cjgriscom/EEGR4253/README.md

# EEGR4253
Microcomputer Design - Spring 2017
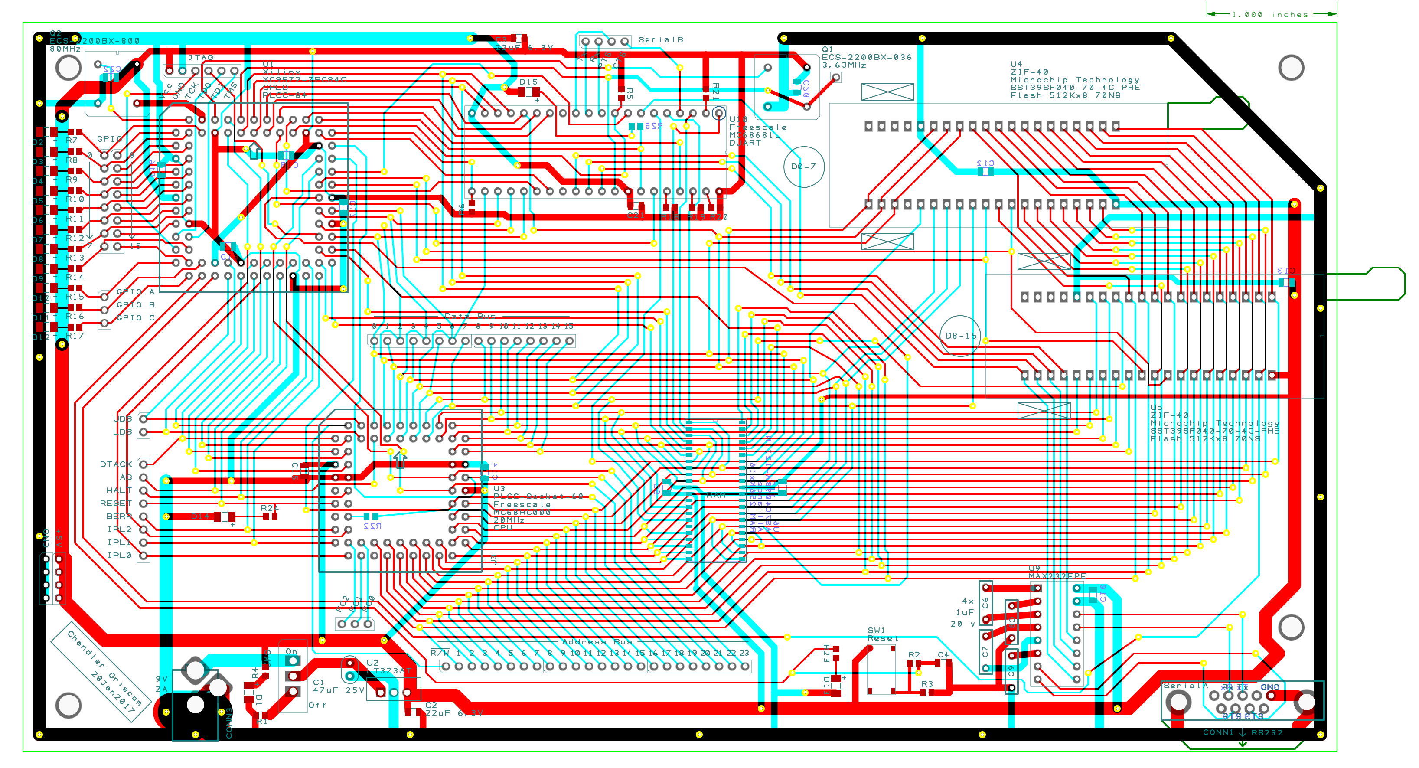
[picture p1: Export/PCB_EXPORT_AllLayers.png]
