cjgriscom/EEGR4253/PCB v2/Computer_v2 (PCB - Back Annotation Renames Report).txt

Back Annotation Renames Report
------------------------------

Report File:        Y:\Homeschool\Semester6\Microcomputer\PCB v2\Computer_v2 (PCB - Back Annotation Renames Report).txt
Report Written:     Tuesday, May 16, 2017
Project Path:       Y:\Homeschool\Semester6\Microcomputer\PCB v2\Computer.prj
Design Path:        Y:\Homeschool\Semester6\Microcomputer\PCB v2\Computer_v2.pcb
Design Title:       
Created:            5/7/2017 6:59:04 PM
Last Saved:         5/16/2017 4:39:36 PM
Editing Time:       10499 min
Units:              inches (precision 3)

Outstanding PCB renames awaiting back annotation to the Schematics design.

Change Value on Component 'D15' - 'Meaning'.
Rename Net from "N0261" to "NRGPLED".
Rename Net from "N0260" to "GPLED".

End Of Report.
