cjgriscom/EEGR4253/Reports/MONITOR PROG.odt

Ignore E pin

lds, uds, dtack, r/w, ce pins

Separate RAM/ROM w/r

Check validity of addresses

Read / write registers

Menu: pg 909

1. Read Register

2. Write Register

3. Read RAM

4. Write RAM

5. Read ROM

6. Write ROM

7. Load S Reg

8. Run S Reg

UI Description, menu flow

CHECK SYLLABUS
