cjgriscom/EEGR4253/Reports/Progress Report 1.odt

Microcomputer Design

Chandler Griscom

18Jan2016

Design Report #1

I. Time
  a. Christmas Break – 3 Hours
  b. Week 1 – 6 Hours
  c. Week 2 – 1 Hour
II. Accomplishments
  a. Ordered CPLD, processor, ZIF and PLCC sockets from eBay
  b. Selected all major components and put them into Digikey/Mouser carts
  c. Made major design decisions and preliminary schematic (emailed)
III. Planned Work
  a. Order all parts by Friday
  b. Begin drawing component footprints in PCBArtist
IV. Project Completion
  a. Hardware: 10%
  b. Software: 0%
