cjgriscom/EEGR4253/Reports/Progress Report 3.odt

Microcomputer Design

Chandler Griscom

01Jan2016

Design Report #3

I. Time – 29.5 Hours total
  a. Week 3 (Wed-Sun) – 20 Hours
  b. Week 4 (Mon-Wed) – 9.5 Hours
II. Accomplishments
  a. Completed schematic and emailed it to Dr. Kim
  b. Verified components, made some symbol corrections
  c. Finished PCB
  d. Ordered PCB!
III. Planned Work
  a. Take a break
  b. Start looking into CPLD programming
IV. Project Completion
  a. Hardware: 90%
  b. Software: 2%


(PCB Progress 30Jan2017)
