cjgriscom/EEGR4253/Reports/Progress Report 7.odt

Microcomputer Design

Chandler Griscom

01Mar2016

Design Report #7

I. Time – 3 Hours total
II. Accomplishments
  a. Helped Colin with DUART and Brian with soldering
  b. Planned out some details related to flash S record storage
  c. I did not finish much else due to tests and projects in CS classes
III. Planned Work
  a. Finish monitor program
  b. Change S record code to permanently upload programs to flash
IV. Project Completion
  a. Hardware: 100%
  b. Software: 80%
