cjgriscom/EEGR4253/Reports/BlockDiagram.pdf

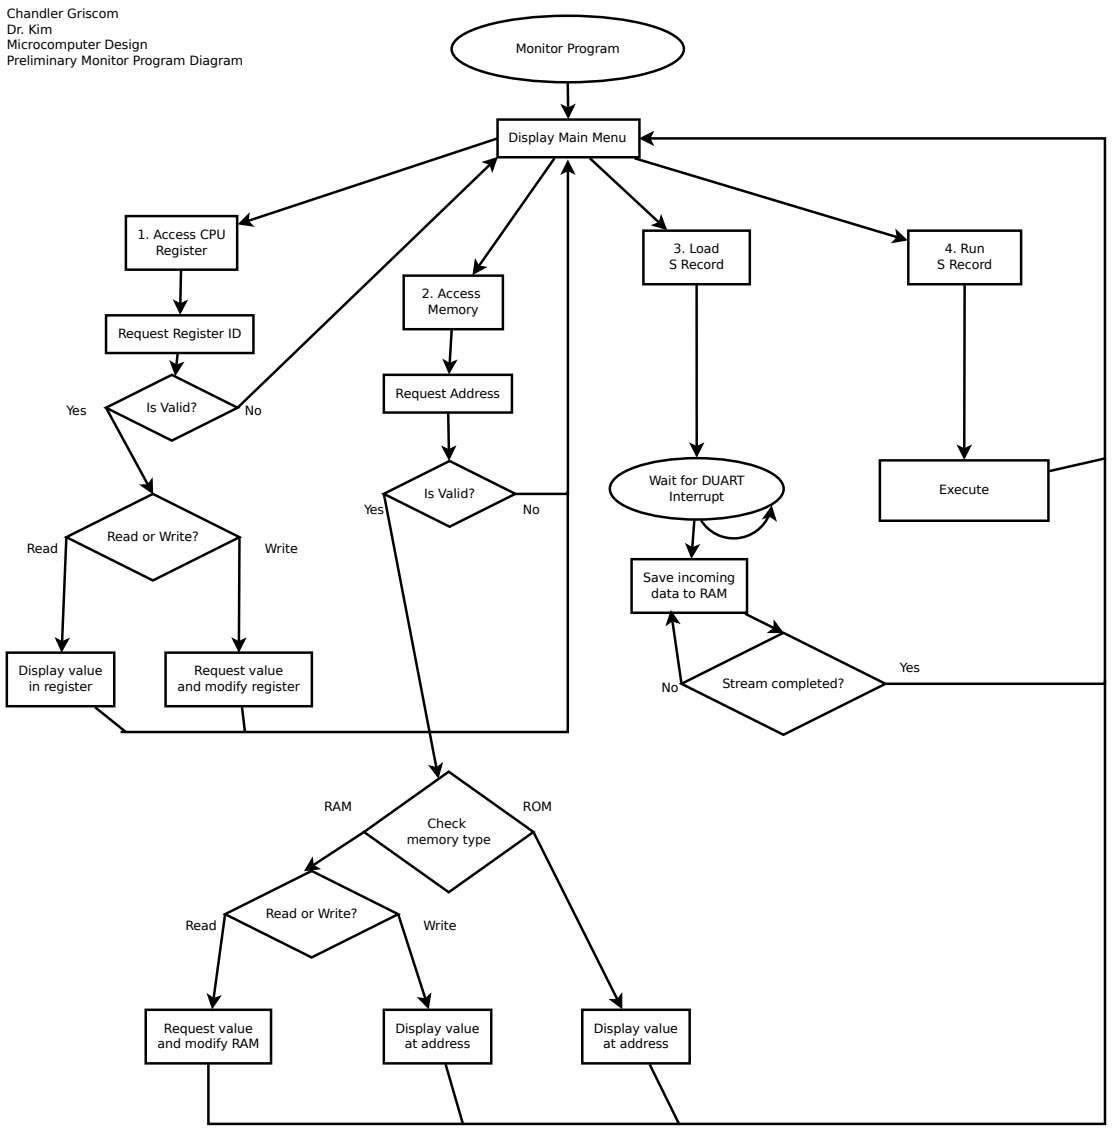
[picture p17: figure]
Display Main Menu; 1. Access CPU Register; 2. Access Memory; 3. Load S Record; 4. Run S Record; Is Valid?; Monitor Program; Chandler Griscom Dr. Kim Microcomputer Design Preliminary Monitor Program Diagram; Wait for DUART Interrupt; Save incoming data to RAM; Stream completed?; Yes; Execute; Request Address; Check memory type; Request Register ID; Read or Write?; Request value and modify register; Request value and modify RAM; Display value at address; Display value in register; Read; Write; RAM; ROM
