cjgriscom/EEGR4253/Monitor Design.ods

ROM Organization
0 | 2000 | 4000 | 6000 | 8000 | … | 40000 | …
Monitor | Reserved | ROMBurner | ProgData | Prog0 |  | Data block 0
ProgData (bytes)
0 | 1 | 2 | 3 | 4 | 5 | 6 | 7 | 8 | 9 | A
Version | Start Addr
