cjgriscom/EEGR4253/Datasheets/68-PCC1.gif

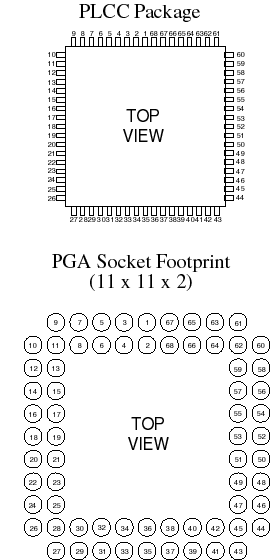
Datasheets/68-PCC1.gif
