cjgriscom/EEGR4253/Datasheets/DEBOUNCE.png

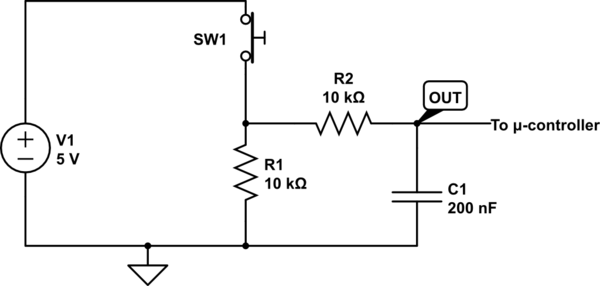
Datasheets/DEBOUNCE.png
