cjgriscom/EEGR4253/Export/0209171253-00.jpg

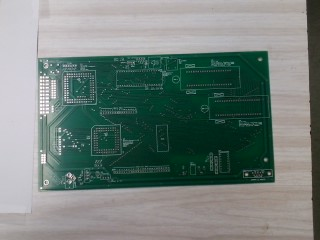
Export/0209171253-00.jpg
