cjgriscom/EEGR4253/Export/0209171253-01.jpg

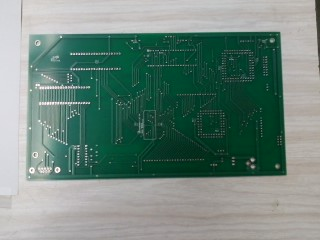
Export/0209171253-01.jpg
