cjgriscom/EEGR4253/Export/boardwhite.png

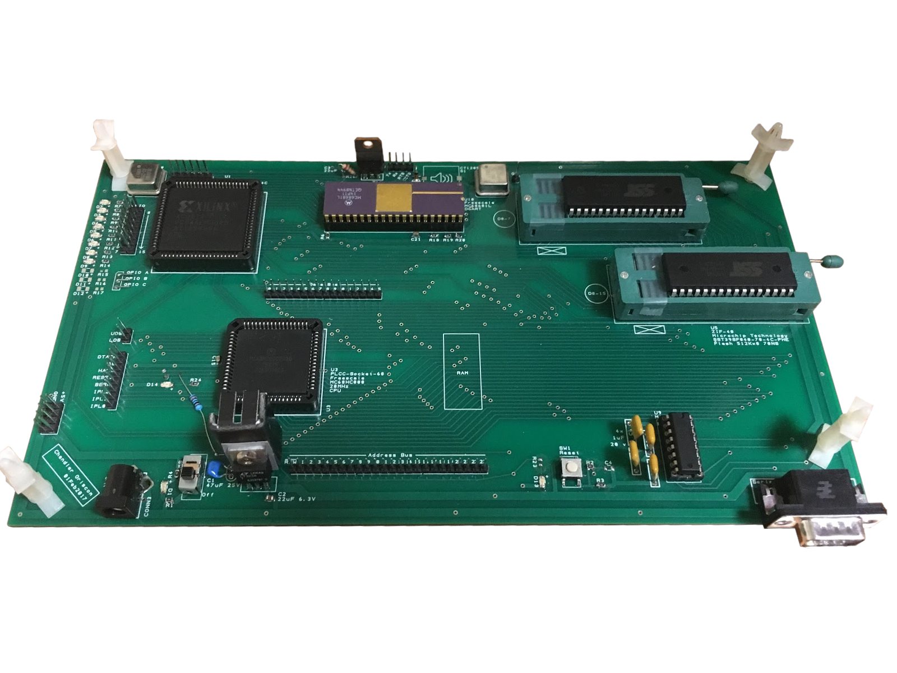
Export/boardwhite.png
