cjgriscom/EEGR4253/Reports/Prelim.png

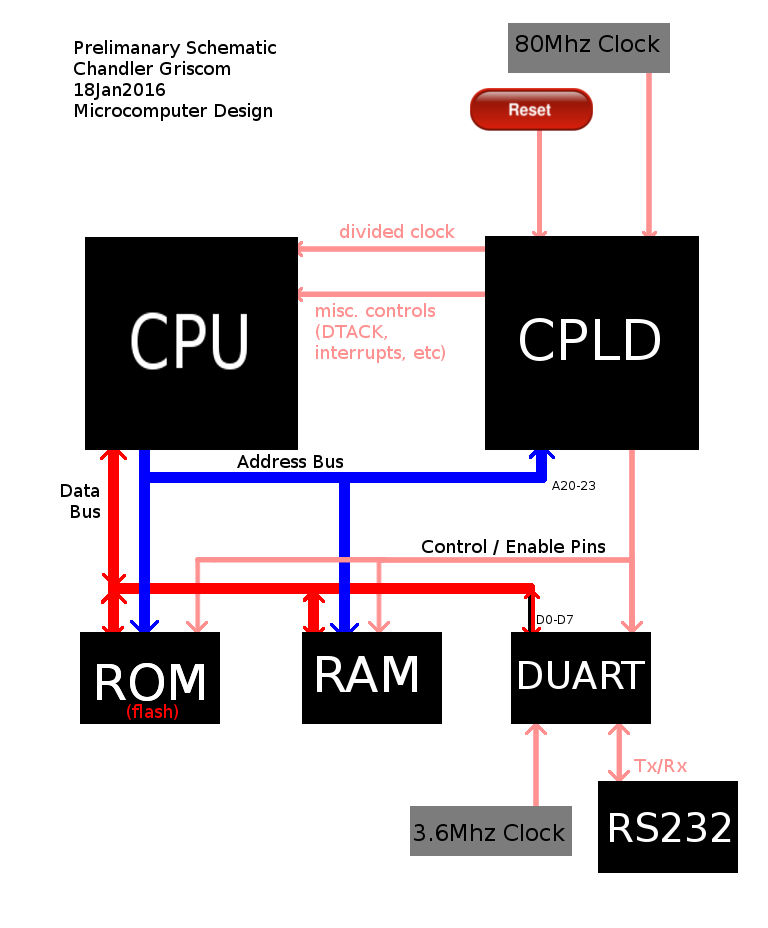
Reports/Prelim.png
