cjgriscom/EEGR4253/MicroprocLibs/Components.txt

Component libraries (*.cml)

=============================

Library : Apem_Switches    {C:\users\Public\Documents\PCB Artist\Library}

===========================================================================

Component   Ref Scm Symbol  Scm Library                                                  Package         Pcb Symbol      Pcb Library
--------------------------------------------------------------------------------------------------------------------------------------------------------------------------------------------------
2554        U   SW2         Apem_Switches {C:\users\Public\Documents\PCB Artist\Library} SWITCH_25546NA  SWITCH_25546NA  Apem_Switches {C:\users\Public\Documents\PCB Artist\Library}
5232CDB     U   SW1_IXI     Apem_Switches {C:\users\Public\Documents\PCB Artist\Library} SWITCH_5232CDB  SWITCH_5232CDB  Apem_Switches {C:\users\Public\Documents\PCB Artist\Library}
5236CDB     U   SW1_IXI     Apem_Switches {C:\users\Public\Documents\PCB Artist\Library} SWITCH_5232CDB  SWITCH_5232CDB  Apem_Switches {C:\users\Public\Documents\PCB Artist\Library}
5237CDB     U   SW1_IXI     Apem_Switches {C:\users\Public\Documents\PCB Artist\Library} SWITCH_5232CDB  SWITCH_5232CDB  Apem_Switches {C:\users\Public\Documents\PCB Artist\Library}
9233CD      U   SW_2P       Switches {C:\users\Public\Documents\PCB Artist\Library}      SWITCH_9233CD   SWITCH_9233CD   Apem_Switches {C:\users\Public\Documents\PCB Artist\Library}
21136NA     U   SW1_IXI     Apem_Switches {C:\users\Public\Documents\PCB Artist\Library} SWITCH_21136    SWITCH_21136    Apem_Switches {C:\users\Public\Documents\PCB Artist\Library}
25136NAH    U   SW1_IXI     Apem_Switches {C:\users\Public\Documents\PCB Artist\Library} SWITCH_25136NAH SWITCH_25136NAH Apem_Switches {C:\users\Public\Documents\PCB Artist\Library}
25146NAH    U   SW2_IXI     Apem_Switches {C:\users\Public\Documents\PCB Artist\Library} SWITCH_25146NAH SWITCH_25146NAH Apem_Switches {C:\users\Public\Documents\PCB Artist\Library}
25336NA     U   SW1_IXI     Apem_Switches {C:\users\Public\Documents\PCB Artist\Library} SWITCH_25336NA  SWITCH_25336NA  Apem_Switches {C:\users\Public\Documents\PCB Artist\Library}
25546NA     U   SW2         Apem_Switches {C:\users\Public\Documents\PCB Artist\Library} SWITCH_25546NA  SWITCH_25546NA  Apem_Switches {C:\users\Public\Documents\PCB Artist\Library}
DS02        U   SW4_A       Apem_Switches {C:\users\Public\Documents\PCB Artist\Library} SWITCH_DS02V    SWITCH_DS02V    Apem_Switches {C:\users\Public\Documents\PCB Artist\Library}
DS02V       U   SW4_A       Apem_Switches {C:\users\Public\Documents\PCB Artist\Library} SWITCH_DS02V    SWITCH_DS02V    Apem_Switches {C:\users\Public\Documents\PCB Artist\Library}
DS04        U   SW6_A       Apem_Switches {C:\users\Public\Documents\PCB Artist\Library} SWITCH_DS04V    SWITCH_DS04V    Apem_Switches {C:\users\Public\Documents\PCB Artist\Library}
DS04V       U   SW6_A       Apem_Switches {C:\users\Public\Documents\PCB Artist\Library} SWITCH_DS04V    SWITCH_DS04V    Apem_Switches {C:\users\Public\Documents\PCB Artist\Library}
DS06        U   SW6_A       Apem_Switches {C:\users\Public\Documents\PCB Artist\Library} SWITCH_DS06V    SWITCH_DS06V    Apem_Switches {C:\users\Public\Documents\PCB Artist\Library}
DS06V       U   SW6_A       Apem_Switches {C:\users\Public\Documents\PCB Artist\Library} SWITCH_DS06V    SWITCH_DS06V    Apem_Switches {C:\users\Public\Documents\PCB Artist\Library}
DS08        U   SW8_A       Apem_Switches {C:\users\Public\Documents\PCB Artist\Library} SWITCH_DS08V    SWITCH_DS08V    Apem_Switches {C:\users\Public\Documents\PCB Artist\Library}
DS08V       U   SW8_A       Apem_Switches {C:\users\Public\Documents\PCB Artist\Library} SWITCH_DS08V    SWITCH_DS08V    Apem_Switches {C:\users\Public\Documents\PCB Artist\Library}
DS10        U   SW10_A      Apem_Switches {C:\users\Public\Documents\PCB Artist\Library} SWITCH_DS10V    SWITCH_DS10V    Apem_Switches {C:\users\Public\Documents\PCB Artist\Library}
DS10V       U   SW10_A      Apem_Switches {C:\users\Public\Documents\PCB Artist\Library} SWITCH_DS10V    SWITCH_DS10V    Apem_Switches {C:\users\Public\Documents\PCB Artist\Library}
NDI04S      U   SW4_A       Apem_Switches {C:\users\Public\Documents\PCB Artist\Library} SWITCH_NDI04SVX SWITCH_NDI04SVX Apem_Switches {C:\users\Public\Documents\PCB Artist\Library}
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
MLL4760   D   DIODE-1    Diode {C:\users\Public\Documents\PCB Artist\Library} MLL41   MLL41
MLL4761   D   DIODE-1    Diode {C:\users\Public\Documents\PCB Artist\Library} MLL41   MLL41
MLL4762   D   DIODE-1    Diode {C:\users\Public\Documents\PCB Artist\Library} MLL41   MLL41
MLL4763   D   DIODE-1    Diode {C:\users\Public\Documents\PCB Artist\Library} MLL41   MLL41
MLL4764   D   DIODE-1    Diode {C:\users\Public\Documents\PCB Artist\Library} MLL41   MLL41
MZ605     D   DIODE-1    Diode {C:\users\Public\Documents\PCB Artist\Library} DIOD04  DIOD04     discrete {C:\users\Public\Documents\PCB Artist\Library}
MZ610     D   DIODE-1    Diode {C:\users\Public\Documents\PCB Artist\Library} DIOD04  DIOD04     discrete {C:\users\Public\Documents\PCB Artist\Library}
MZ620     D   DIODE-1    Diode {C:\users\Public\Documents\PCB Artist\Library} DIOD04  DIOD04     discrete {C:\users\Public\Documents\PCB Artist\Library}
MZ640     D   DIODE-1    Diode {C:\users\Public\Documents\PCB Artist\Library} DIOD04  DIOD04     discrete {C:\users\Public\Documents\PCB Artist\Library}
MZ2361    D   DIODE-2    Diode {C:\users\Public\Documents\PCB Artist\Library} DIOD05  DIOD05

Library : discrete    {C:\users\Public\Documents\PCB Artist\Library}

======================================================================

Component Ref  Scm Symbol Scm Library                                             Package Pcb Symbol  Pcb Library
--------------------------------------------------------------------------------------------------------------------------------------------------------------------------
7SEG      DISP 7SEG2      discrete {C:\users\Public\Documents\PCB Artist\Library} DIP     LED10DIL300 discrete {C:\users\Public\Documents\PCB Artist\Library}
Battery   BAT  Battery    discrete {C:\users\Public\Documents\PCB Artist\Library} MISC    Battery     discrete {C:\users\Public\Documents\PCB Artist\Library}
C         C    C          discrete {C:\users\Public\Documents\PCB Artist\Library} SM      C0805
                                                                                  DSC     DISC03      discrete {C:\users\Public\Documents\PCB Artist\Library}
CP        C    CP         discrete {C:\users\Public\Documents\PCB Artist\Library} SM      C3527
                                                                                  DSCV    CAPP3V      discrete {C:\users\Public\Documents\PCB Artist\Library}
CP-SM     C    CP         discrete {C:\users\Public\Documents\PCB Artist\Library} SM      C3527
                                                                                  DSCV    CAPP3V      discrete {C:\users\Public\Documents\PCB Artist\Library}
CP1       C    CP         discrete {C:\users\Public\Documents\PCB Artist\Library} DSCV    CAPP1V      discrete {C:\users\Public\Documents\PCB Artist\Library}
CP3       C    CP         discrete {C:\users\Public\Documents\PCB Artist\Library} DSCV    CAPP3V      discrete {C:\users\Public\Documents\PCB Artist\Library}
CP4       C    CP         discrete {C:\users\Public\Documents\PCB Artist\Library} DSCV    CAPP4V      discrete {C:\users\Public\Documents\PCB Artist\Library}
CP5       C    CP         discrete {C:\users\Public\Documents\PCB Artist\Library} DSCV    CAPP5V      discrete {C:\users\Public\Documents\PCB Artist\Library}
CP6       C    CP         discrete {C:\users\Public\Documents\PCB Artist\Library} DSCV    CAPP6V      discrete {C:\users\Public\Documents\PCB Artist\Library}
CT1       C    CT         discrete {C:\users\Public\Documents\PCB Artist\Library} DSC     CT3         discrete {C:\users\Public\Documents\PCB Artist\Library}
                                                                                  DSCV    CT5         discrete {C:\users\Public\Documents\PCB Artist\Library}
                                                                                  MISC    CT1         discrete {C:\users\Public\Documents\PCB Artist\Library}
CT2       C    CT         discrete {C:\users\Public\Documents\PCB Artist\Library} DSC     CT4         discrete {C:\users\Public\Documents\PCB Artist\Library}
                                                                                  DSCV    CT6         discrete {C:\users\Public\Documents\PCB Artist\Library}
                                                                                  MISC    CT2         discrete {C:\users\Public\Documents\PCB Artist\Library}
CV1       C    CV         discrete {C:\users\Public\Documents\PCB Artist\Library} DSC     CV1         discrete {C:\users\Public\Documents\PCB Artist\Library}
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
R_PRE     R    RP         discrete {C:\users\Public\Documents\PCB Artist\Library} DSC     POT1H       discrete {C:\users\Public\Documents\PCB Artist\Library}
                                                                                  DSCV    POT1V       discrete {C:\users\Public\Documents\PCB Artist\Library}
R_PREC    R    RP         discrete {C:\users\Public\Documents\PCB Artist\Library} DSC     POT2H       discrete {C:\users\Public\Documents\PCB Artist\Library}
                                                                                  DSCV    POT2V       discrete {C:\users\Public\Documents\PCB Artist\Library}
R_PREM    R    RP         discrete {C:\users\Public\Documents\PCB Artist\Library} DSC     POT3H       discrete {C:\users\Public\Documents\PCB Artist\Library}
                                                                                  DSCV    POT3V       discrete {C:\users\Public\Documents\PCB Artist\Library}
SCR       D    SCR        discrete {C:\users\Public\Documents\PCB Artist\Library} SM      SOT23
SPDT      SW   SPDT       switch {C:\users\Public\Documents\PCB Artist\Library}   DSC     SPDTHH      discrete {C:\users\Public\Documents\PCB Artist\Library}
                                                                                  DSCV    SPDTV       discrete {C:\users\Public\Documents\PCB Artist\Library}
                                                                                  MISC    SPDTHV      discrete {C:\users\Public\Documents\PCB Artist\Library}
SW_FSM2JH SW   PUSH-NO    switch {C:\users\Public\Documents\PCB Artist\Library}   DISC    FSM2JH      discrete {C:\users\Public\Documents\PCB Artist\Library}
TRIAC     D    TRIAC      discrete {C:\users\Public\Documents\PCB Artist\Library} SM      SOT23
                                                                                  DSC     TO92        discrete {C:\users\Public\Documents\PCB Artist\Library}
XTAL      XTAL XTAL       discrete {C:\users\Public\Documents\PCB Artist\Library} DSC     HC18U       discrete {C:\users\Public\Documents\PCB Artist\Library}
ZENER     ZD   ZENERD     discrete {C:\users\Public\Documents\PCB Artist\Library} DSC     DIOD03      discrete {C:\users\Public\Documents\PCB Artist\Library}
                                                                                  MISC    DIOD04      discrete {C:\users\Public\Documents\PCB Artist\Library}

Library : Finder_Relays    {C:\users\Public\Documents\PCB Artist\Library}

===========================================================================

Component        Ref Scm Symbol     Scm Library                                           Package          Pcb Symbol       Pcb Library
----------------------------------------------------------------------------------------------------------------------------------------------------
30.22.7.005.0010 U   RELAY_SW2_C1   Relays {C:\users\Public\Documents\PCB Artist\Library} RELAY_30XXX      RELAY_30XXX
30.22.7.012.0010 U   RELAY_SW2_C1   Relays {C:\users\Public\Documents\PCB Artist\Library} RELAY_30XXX      RELAY_30XXX
30.22.7.024.0010 U   RELAY_SW2_C1   Relays {C:\users\Public\Documents\PCB Artist\Library} RELAY_30XXX      RELAY_30XXX
32.21.7.005.2000 U   RELAY_SW1_C1   Relays {C:\users\Public\Documents\PCB Artist\Library} RELAY_32XXX      RELAY_32XXX
32.21.7.012.2000 U   RELAY_SW1_C1   Relays {C:\users\Public\Documents\PCB Artist\Library} RELAY_32XXX      RELAY_32XXX
32.21.7.024.2000 U   RELAY_SW1_C1   Relays {C:\users\Public\Documents\PCB Artist\Library} RELAY_32XXX      RELAY_32XXX
34.51.7.005.0010 U   RELAY_SW1_C1   Relays {C:\users\Public\Documents\PCB Artist\Library} RELAY_34.51      RELAY_34.51
34.51.7.024.0019 U   RELAY_SW1_C1   Relays {C:\users\Public\Documents\PCB Artist\Library} RELAY_34.51      RELAY_34.51
34.81.7.005.8240 U   RELAY_SW1_C1_A Relays {C:\users\Public\Documents\PCB Artist\Library} RELAY_34.81      RELAY_34.81
34.81.7.005.9024 U   RELAY_SW1_C1_A Relays {C:\users\Public\Documents\PCB Artist\Library} RELAY_34.81      RELAY_34.81
34.81.7.012.9024 U   RELAY_SW1_C1_A Relays {C:\users\Public\Documents\PCB Artist\Library} RELAY_34.81      RELAY_34.81
34.81.7.024.8240 U   RELAY_SW1_C1_A Relays {C:\users\Public\Documents\PCB Artist\Library} RELAY_34.81      RELAY_34.81
34.81.7.024.9024 U   RELAY_SW1_C1_A Relays {C:\users\Public\Documents\PCB Artist\Library} RELAY_34.81      RELAY_34.81
36.11.9.005.0000 U   RELAY_SW1_C1   Relays {C:\users\Public\Documents\PCB Artist\Library} RELAY_36.11.0000 RELAY_36.11.0000
36.11.9.012.0000 U   RELAY_SW1_C1   Relays {C:\users\Public\Documents\PCB Artist\Library} RELAY_36.11.0000 RELAY_36.11.0000
36.11.9.024.0000 U   RELAY_SW1_C1   Relays {C:\users\Public\Documents\PCB Artist\Library} RELAY_36.11.0000 RELAY_36.11.0000
36.11.9.024.0300 U   RELAY_SW1_C1_A Relays {C:\users\Public\Documents\PCB Artist\Library} RELAY_36.11.0300 RELAY_36.11.0300
40.31.7.012.0000 U   RELAY_SW1_C1   Relays {C:\users\Public\Documents\PCB Artist\Library} RELAY_40.31      RELAY_40.31
40.31.7.024.0000 U   RELAY_SW1_C1   Relays {C:\users\Public\Documents\PCB Artist\Library} RELAY_40.31      RELAY_40.31
40.31.8.012.0000 U   RELAY_SW1_C1   Relays {C:\users\Public\Documents\PCB Artist\Library} RELAY_40.31      RELAY_40.31
40.31.8.024.0000 U   RELAY_SW1_C1   Relays {C:\users\Public\Documents\PCB Artist\Library} RELAY_40.31      RELAY_40.31
40.31.8.110.0000 U   RELAY_SW1_C1   Relays {C:\users\Public\Documents\PCB Artist\Library} RELAY_40.31      RELAY_40.31
40.31.8.230.0000 U   RELAY_SW1_C1   Relays {C:\users\Public\Documents\PCB Artist\Library} RELAY_40.31      RELAY_40.31
40.31.7006.0000  U   RELAY_SW1_C1   Relays {C:\users\Public\Documents\PCB Artist\Library} RELAY_40.31      RELAY_40.31
40.51.9.012.0000 U   RELAY_SW1_C1   Relays {C:\users\Public\Documents\PCB Artist\Library} RELAY_40.51      RELAY_40.51
40.51.9024.000   U   RELAY_SW1_C1   Relays {C:\users\Public\Documents\PCB Artist\Library} RELAY_40.51      RELAY_40.51
40.52.7.006.0000 U   RELAY_SW2_C1   Relays {C:\users\Public\Documents\PCB Artist\Library} RELAY_40.52      RELAY_40.52
40.52.7.012.0000 U   RELAY_SW2_C1   Relays {C:\users\Public\Documents\PCB Artist\Library} RELAY_40.52      RELAY_40.52
40.52.7.024.0000 U   RELAY_SW2_C1   Relays {C:\users\Public\Documents\PCB Artist\Library} RELAY_40.52      RELAY_40.52
40.52.7.048.0000 U   RELAY_SW2_C1   Relays {C:\users\Public\Documents\PCB Artist\Library} RELAY_40.52      RELAY_40.52
40.52.8.012.0000 U   RELAY_SW2_C1   Relays {C:\users\Public\Documents\PCB Artist\Library} RELAY_40.52      RELAY_40.52
40.52.8.024.0000 U   RELAY_SW2_C1   Relays {C:\users\Public\Documents\PCB Artist\Library} RELAY_40.52      RELAY_40.52
40.52.8.110.0000 U   RELAY_SW2_C1   Relays {C:\users\Public\Documents\PCB Artist\Library} RELAY_40.52      RELAY_40.52
40.52.8.230.0000 U   RELAY_SW2_C1   Relays {C:\users\Public\Documents\PCB Artist\Library} RELAY_40.52      RELAY_40.52
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
62.32.8230.0010  U   RELAY_SW2_C1   Relays {C:\users\Public\Documents\PCB Artist\Library} RELAY_62.32      RELAY_62.32
3451.7012.0010   U   RELAY_SW1_C1   Relays {C:\users\Public\Documents\PCB Artist\Library} RELAY_34.51      RELAY_34.51
3451.7024.0010   U   RELAY_SW1_C1   Relays {C:\users\Public\Documents\PCB Artist\Library} RELAY_34.51      RELAY_34.51
3451.7060.0010   U   RELAY_SW1_C1   Relays {C:\users\Public\Documents\PCB Artist\Library} RELAY_34.51      RELAY_34.51
4452 9012        U   RELAY_SW2_C1   Relays {C:\users\Public\Documents\PCB Artist\Library} RELAY_44.52      RELAY_44.52
4452 9024        U   RELAY_SW2_C1   Relays {C:\users\Public\Documents\PCB Artist\Library} RELAY_44.52      RELAY_44.52
4452 9048        U   RELAY_SW2_C1   Relays {C:\users\Public\Documents\PCB Artist\Library} RELAY_44.52      RELAY_44.52
4661.8012.0040   U   RELAY_SW1_C1   Relays {C:\users\Public\Documents\PCB Artist\Library} RELAY_46.61      RELAY_46.61
5532.8024.0040   U   RELAY_55.32    Relays {C:\users\Public\Documents\PCB Artist\Library} RELAY_55.32      RELAY_55.32
5532.8230.0040   U   RELAY_55.32    Relays {C:\users\Public\Documents\PCB Artist\Library} RELAY_55.32      RELAY_55.32
5532.9012.0040   U   RELAY_55.32    Relays {C:\users\Public\Documents\PCB Artist\Library} RELAY_55.32      RELAY_55.32
5532.9024.0040   U   RELAY_55.32    Relays {C:\users\Public\Documents\PCB Artist\Library} RELAY_55.32      RELAY_55.32
5532.9048.0040   U   RELAY_55.32    Relays {C:\users\Public\Documents\PCB Artist\Library} RELAY_55.32      RELAY_55.32
5534.9048.0040   U   RELAY_SW4_C1_A Relays {C:\users\Public\Documents\PCB Artist\Library} RELAY_55.34      RELAY_55.34
501290051000     U   RELAY_SW2_C1   Relays {C:\users\Public\Documents\PCB Artist\Library} RELAY_50XXX      RELAY_50XXX
501290121000     U   RELAY_SW2_C1   Relays {C:\users\Public\Documents\PCB Artist\Library} RELAY_50XXX      RELAY_50XXX
501290241000     U   RELAY_SW2_C1   Relays {C:\users\Public\Documents\PCB Artist\Library} RELAY_50XXX      RELAY_50XXX
501290481000     U   RELAY_SW2_C1   Relays {C:\users\Public\Documents\PCB Artist\Library} RELAY_50XXX      RELAY_50XXX
501291101000     U   RELAY_SW2_C1   Relays {C:\users\Public\Documents\PCB Artist\Library} RELAY_50XXX      RELAY_50XXX

Library : Fuse    {C:\users\Public\Documents\PCB Artist\Library}

==================================================================

Component    Ref Scm Symbol Scm Library                                             Package    Pcb Symbol Pcb Library
----------------------------------------------------------------------------------------------------------------------------------
491-1A       FS  FUSE       discrete {C:\users\Public\Documents\PCB Artist\Library} FUSE Axial FUSE Axial
491-1.25A    FS  FUSE       discrete {C:\users\Public\Documents\PCB Artist\Library} FUSE Axial FUSE Axial
491-2A       FS  FUSE       discrete {C:\users\Public\Documents\PCB Artist\Library} FUSE Axial FUSE Axial
491-2.5A     FS  FUSE       discrete {C:\users\Public\Documents\PCB Artist\Library} FUSE Axial FUSE Axial
491-3A       FS  FUSE       discrete {C:\users\Public\Documents\PCB Artist\Library} FUSE Axial FUSE Axial
491-3.15a    FS  FUSE       discrete {C:\users\Public\Documents\PCB Artist\Library} FUSE Axial FUSE Axial
491-4A       FS  FUSE       discrete {C:\users\Public\Documents\PCB Artist\Library} FUSE Axial FUSE Axial
491-5A       FS  FUSE       discrete {C:\users\Public\Documents\PCB Artist\Library} FUSE Axial FUSE Axial
491-250mA    FS  FUSE       discrete {C:\users\Public\Documents\PCB Artist\Library} FUSE Axial FUSE Axial
491-300mA    FS  FUSE       discrete {C:\users\Public\Documents\PCB Artist\Library} FUSE Axial FUSE Axial
491-400mA    FS  FUSE       discrete {C:\users\Public\Documents\PCB Artist\Library} FUSE Axial FUSE Axial
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
MF-R800      FS  FUSE       discrete {C:\users\Public\Documents\PCB Artist\Library} MF-R-3     MF-R-3

Library : hybrid    {C:\users\Public\Documents\PCB Artist\Library}

====================================================================
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
