cjgriscom/EEGR4253/Project Organizer.ods

Sheet: TimeSheet
Time Sheet
 | Hours (Estimated)
Break | 3 | Researched and bought CPLD, 68k, CPLD socket from eBay
Week 1 | 2 | Selecting and ordering parts
 | 2.5 | Selecting and ordering parts
 | 1 | Attend Friday Lab Meeting and work on prelim schematic | 9.5
Week 2 | 1 | Finish Prelim Schematic, write progress report
 | 4.5 | Completed ALL component selection. Ordered DUART, AC adaptor, serial cables from eBay & Amazon
 | 2 | Switch out some resistors & capacitors, place Mouser and Digikey orders | 13
 | 4.5 | Download and draw symbols
 | 2 | Finish drawing symbols
Week 3 | 2 | Begin Schematic – RS232, Reset Debounce, Regulator | 18
 | 9 | Work on Schematic
 | 1 | Lab – Talk to josh about block diagram
 | 1 | Explore DUART functionality
 | 3 | Edit schematic (add 80% of testpoints, remove unneeded connections)
 | 2 | Consult Josh during lab regarding schematic, soldering, DUART, work on block diagram
 | 3 | Work on Schematic
 | 1 | Start researching and laying out PCB | 20
 | 6 | PCB Layout (assemble busses, connect most chips) | 9.5
 | 5 | PCB Layout (route CPLD)
 | 2 | PCB Layout (sync CPLD with schematic, add capacitors)
 | 3 | Add labels, more LEDS
Week 4 | 2 | Edit schematic and PCB; change WE, CE, OE busses
 | 2.5 | Make schematic look good, make CPLD netlist, final schematic export
 | 2 | Lab with Josh, fit components to printout, fix power jack mistake
 | 1 | Add speaker to unused CPLD pin
 | 1 | Verify parts against datasheets
 | 1 | Order board!!!
 | 1 | Begin VHDL code (netlist, constraints file)
 | 3 | Work on VHDL (read/write logic) | 12
 | 7 | Finish most of VHDL (implemented all chip logic, dtack, interrupts, gpio)
Week 5 | 0.5 | Redo schematic 11x17
 | 0.5 | Go to lab, write progress report
 | 1 | Setup pulseview/sigrok for saleae logic analyser
 | 0.5 | Test logic analyser using 555 timer (success!) | 13.5
 | 3 | Solder all but RAM
 | 4 | Test VHDL
 | 5 | Get ROM Working
Week 6 | 5 | Debug sporadic issues caused by lack of BGACK
 | 0.5 | Got RAM working!
 | 4 | Working periodic (IPL7) interrupts | 18.75
 | 4 | Duart loopback test is working
 | 5 | Working duart communication (polling)
 | 0.25 | Working duart (IPL6) interrupts!
 | 4 | Write and debug hello world program
 | 6 | Program 'bootloader' with S record upload capability
 | 2 | Write Bash script for sending S records to bootloader | 25
 | 2 | Update clock to 20Mhz, add heatsink
 | 3 | Debug and fix DUART interrupts
 | 5 | Work on / research ROM burning from the CPU. Started monitor program
 | 3 | Write VHDL modifications and 68k code for hotswapping ROM chips
Week 7 | 7 | Finished ROM burner – can now overwrite boot record | 7.5 | 32.5
 | 0.5 | Establish DUART channel B communication
Week 8 | 3 | Help Colin/Brian with stuff, plan out flash storage formats
 | 12 | Add ROM-writing functionality to Monitor program for uploading S Records
Week 9 | 4 | Finish monitor program (view/edit memory and registers)
 | 0.5 | Write RC Car S Record
Week 10 | 0.5 | Presentation in Digital Class
Total | 166.75 | hours

Sheet: Memory+Interrupts
 | A23 | A22 | A21 | A20 | MODE |  |  |  | Interrupts | IPL2 | IPL1 | IPL0 | Meaning
F | 1 | x | x | x | CPLD | GPI/GPO |  |  | 7 | 1 | 1 | 1 | 1000Hz Periodic
E | 1 | x | x | x | CPLD | GPI/GPO |  |  | 6 | 1 | 1 | 0 | DUART
D | 1 | x | x | x | CPLD | GPI/GPO |  |  | 5 | 1 | 0 | 1
C | 1 | x | x | x | CPLD | GPI/GPO |  |  | 4 | 1 | 0 | 0
B | 1 | x | x | x | CPLD | GPI/GPO |  |  | 3 | 0 | 1 | 1
A | 1 | x | x | x | CPLD | GPI/GPO |  |  | 2 | 0 | 1 | 0
9 | 1 | x | x | x | CPLD | GPI/GPO |  |  | 1 | 0 | 0 | 1 | Peripheral
8 | 1 | x | x | x | CPLD | GPI/GPO |  |  | 0 | 0 | 0 | 0
7 | 0 | 1 | x | x
6 | 0 | 1 | x | x |  |  | Masks: | Enable/disable speaker, use data pins as interrupt vector, use data pins as buffer
5 | 0 | 1 | x | x
4 | 0 | 1 | x | x
3 | 0 | 0 | 1 | 1 | CPLD | CPLD Masks
2 | 0 | 0 | 1 | 0 | DUART | A19-16 used for mode-setting
1 | 0 | 0 | 0 | 1 | RAM |  |  | CPLD MASK
0 | 0 | 0 | 0 | 0 | ROM |  |  | 7 | 6 | 5 | 4 | 3 | 2 | 1 | 0
 |  |  |  |  |  |  |  |  |  |  | Pause CPU | Speaker_En | Reset DUART | GPI_FlowCtrl

Sheet: Parts
Sheet 1: Parts list
Sheet 2: Supply requirements |  |  |  |  | MicroComputer Design
Sheet 3: Symbol/Pattern/Component Progress |  |  |  |  | Sample by Dr. kim
Sheet 4: Time Sheet
Sheet 5: Project Progress
Master Parts List
Item | Symbols | Quantity | Price(each) | Price(sum) | Description | Manufacturers Part Number |  | Website of Part
Processor |  | 5 | 2.26 | 11.28 | 68000 CPU 20MHz, 64-pin PLCC | MC68HC000FN20 | J | eBay
Sold Processor |  | 1 | (2.00) | (2.00) | CPU purchased by Brian
Processor Socket |  | 2 | 1.42 | 2.84 | CONN SOCKET PLCC 68POS TIN | AE10059-ND |  | digikey
CPU Oscillator |  | 1 | 2.37 | 2.37 | OSC XO 80.000MHZ TTL PC PIN | XC1194-ND |  | digikey
Oscillator Sockets |  | 2 | 0.25 | 0.50 | 8-pin dip socket |  |  | supply closet
CPLD |  | 2 | 8.00 | 16.00 | IC CPLD 72 MCELL C-TEMP 84-PLCC | XC9572-7PC84C |  | eBay
CPLD Socket |  | 5 | 0.51 | 2.56 | 5x PLCC IC Socket DIP 84 PINS PLCC-84 | ? |  | eBay
Jtag | 6-pin | 3 | 0.68 | 2.04 | Headers & Wire Housings 16CKT VERT HDR | 22-28-4161 | m | http://www.mouser.com/Search/ProductDetail.aspx?qs=GAPJcf4kvdv3Xd3iPYTA6w%3d%3d
DUART |  | 2 | 5.00 | 9.99 | 40-DIP | MC68681L |  | eBay
Duart Socket |  | 1 | 1.02 | 1.02 | CONN SOCKET PLCC 44POS TIN | AE10057-ND |  | digikey
Duart CLK |  | 1 | 1.88 | 1.88 | OSC 3.6864 MHZ 5.0V FULL SIZE | XC1158-ND |  | digikey
RS232 Driver |  | 2 | 1.37 | 2.74 | IC DUAL RS232 ESD-PROT 16-DIP 250kbps | MAX232EIN |  | digikey | Needs some 1uF caps
RS232 Driver Socket |  | 1 | 0.50 | 0.50 | 16-pin dip socket |  |  | supply closet
D-Sub connector |  | 1 | 1.54 | 1.54 | CONN D-SUB PLUG 9POS R/A SOLDER | A109020-ND |  | digikey
Ram |  | 2 | 4.98 | 9.96 | IC SRAM 4MBIT 12NS 44SOJ | AS7C4098A-12JIN |  | digikey
Rom |  | 4 | 1.67 | 6.68 | IC FLASH 4MBIT 70NS 32DIP | SST39SF040-70-4C |  | digikey
Rom ZIF Socket |  | 2 | 2.49 | 4.98 | 40Pin ZIF ZIP DIP |  |  | ebay
5v Regulator |  | 1 | 4.27 | 4.27 | IC REG LDO 5V 3A TO220-3 | LT323AT |  | digikey
ON/OFF switch |  | 2 | 1.09 | 2.18 | Slide Switches MINI SLIDE SWITCH | SLA1200 | m | mouser
Reset Button |  | 2 | 0.76 | 1.52 | SWITCH TACT 6MM SMD MOM 160GF | B3S-1000 |  | http://search.digikey.com/scripts/DkSearch/dksus.dll?Detail?name=SW415-ND
LEDs |  | 18 | 0.31 | 5.63 | SMD 3.2X1.6MM LOW CRNT Blue | APT3216LVBC/D | m | http://www.mouser.com/Search/ProductDetail.aspx?qs=7JStj%2fjQ2SEA%252b%2fUbcPiheQ%3d%3d
Resistor 1.0k | Online | 100 | 0.01 | 0.60 | SMD 0805 1Kohms 5% AEC-Q200 | ERJ-6GEYJ102V | m | mouser
Resistor 4.7k | Online | 100 | 0.01 | 0.60 | SMD 0805 4.7Kohms 5% AEC-Q200 | ERJ-6GEYJ472V | m | mouser
Capacitor 1 uF | Online | 35 | 0.04 | 1.33 | MLCC - SMD/SMT 0805 1uF 16volts X5R 10% | GRM21BR61C105KA01L | m | mouser
Capacitor 22 uF 6.3V | Online | 2 | 0.24 | 0.48 | MLCC - SMD/SMT 0805 22uF 6.3volts X5R 20% | GRM21BR60J226ME39L | m | mouser
Capacitor 47 uF 25V |  | 1 | 0.99 | 0.99 | Ceramic Leaded 47uF 25volts X5R 20% Radial ThruHole | FG16X5R1E476MRT00 | m | mouser
Barrel Plug (Male) |  | 1 | 0.85 | 0.85 | CONN PWR JACK 2.1X5.5MM SOLDER | EJ508A-ND |  | digikey
9V AC Adaptor |  | 1 | 6.59 | 6.59 | 9V 2A 2000mA DC AC Adapter Charger | - |  | ebay
Logic Analyser |  | 1 | 6.79 | 6.79
PCB Board |  | 1 | 33.00 | 33.00
PCB Shipping and H |  | 1 | 22.00 | 22.00
Digikey Shipping |  | 1 | 10.55 | 10.55
Mouser Shipping+Tax |  | 1 | 7.77 | 7.77
68000 Shipping |  | 1 | 2.00 | 2.00
DUART Shipping |  | 1 | 2.50 | 2.50
CPLD Shipping |  | 1 | 4.10 | 4.10
84pin socket shipping |  | 1 | 1.85 | 1.85
ZIF socket shipping |  | 1 | 2.54 | 2.54
 |  |  | Total Cost w/ Shipping | 193.02
 |  |  |  |  | Shipping Costs | 53.31

Sheet: Digikey
Web ID | Access ID | Salesorder Number | Shipping Method | Payment Method
162836272 | 55061 | 49131690 | U.S. Postal Service First Class Mail* (order by 8:00 PM CT) | VISA
Shipping Address
First Name | Last Name | Company | Mail Stop | Address Line 1 | Address Line 2 | City | State | Postal Code | Country | Email Address | Telephone
Chandler | Griscom CPO#1965 | LeTourneau University |  | LeTourneau University | 2100 S Mobberly Ave | Longview | TX | 75602 | USA | cjgriscom@gmail.com | 4846835249
Billing Address
First Name | Last Name | Company | Mail Stop | Address Line 1 | Address Line 2 | City | State | Postal Code | Country | Email Address | Telephone
Chandler | Griscom |  |  | 9 Country Club Rd. |  | Coatesville | PA | 19320 | USA |  | 4846835249
Index | Quantity | Part Number | Description | Customer Reference | Available Quantity | Backorder Quantity | Unit Price USD | Extended Price USD
1 | 2 | AE10059-ND | CONN SOCKET PLCC 68POS TIN |  | 2 | 0 | 1.42 | 2.84
2 | 2 | AE10057-ND | CONN SOCKET PLCC 44POS TIN |  | 2 | 0 | 1.02 | 2.04
3 | 1 | XC1194-ND | OSC XO 80.000MHZ TTL PC PIN |  | 1 | 0 | 2.37 | 2.37
4 | 1 | XC1158-ND | OSC XO 3.6864MHZ HCMOS TTL PC |  | 1 | 0 | 2.47 | 2.47
5 | 1 | A109020-ND | CONN D-SUB PLUG 9POS R/A SOLDER |  | 1 | 0 | 1.54 | 1.54
6 | 4 | SST39SF040-70-4C-PHE-ND | IC FLASH 4MBIT 70NS 32DIP |  | 4 | 0 | 1.67 | 6.68
7 | 2 | 1450-1238-5-ND | IC SRAM 4MBIT 12NS 44SOJ |  | 2 | 0 | 4.98 | 9.96
8 | 2 | 296-27963-5-ND | IC DUAL RS232 ESD-PROT 16-DIP |  | 2 | 0 | 1.37 | 2.74
9 | 10 | 3M9580-ND | SHUNT JUMPER .1" BLACK GOLD |  | 10 | 0 | 0.094 | 0.94
10 | 1 | EJ508A-ND | CONN PWR JACK 2.1X5.5MM SOLDER |  | 1 | 0 | 0.85 | 0.85
11 | 2 | SW415-ND | SWITCH TACTILE SPST-NO 0.05A 24V |  | 2 | 0 | 0.76 | 1.52
12 | 1 | AE11110-ND | IC PLCC SOCKET 84POS TIN |  | 1 | 0 | 1.37 | 1.37
13 | 1 | LT323AT#PBF-ND | IC REG LDO 5V 3A TO220-3 |  | 1 | 0 | 4.27 | 4.27
 |  |  |  |  |  | Subtotal | 39.59
 |  |  |  |  |  | Shipping | unknown
 |  |  |  |  |  | Estimated Sales Tax | 3.27
 |  |  |  |  |  | Total | unknown

Sheet: Clock_Calculations
note | FREQ | div value | beat(Hz) | bits |  | Freq | Code | Bits | <--- |  |  |  |  | Freq | Code | Bits
C0 | 16.35 |  | 15999983.65000 | 0 | 8MHz | 8000000 | 4 | 3 | Reference Clock |  | Reference Clock |  | 8MHz | 8000000 | 4 | 3
C#0/Db0 | 17.32 |  | 15999982.68000 | 0 |  | 8888888.88888889 | 3.5 | 3 | 40000000 |  | 40000000
D0 | 18.35 |  | 15999981.65000 | 0 |  | 10000000 | 3 | 2 |  |  |  |  |  | 10000000 | 3 | 2
D#0/Eb0 | 19.45 |  | 15999980.55000 | 0 |  | 11428571.4285714 | 2.5 | 2
E0 | 20.6 |  | 15999979.40000 | 0 |  | 13333333.3333333 | 2 | 2 |  |  |  |  |  | 13333333.3333333 | 2 | 2
F0 | 21.83 |  | 15999978.17000 | 0 |  | 16000000 | 1.5 | 2
F#0/Gb0 | 23.12 |  | 15999976.88000 | 0 |  | 20000000 | 1 | 1 |  |  |  |  |  | 20000000 | 1 | 1
G0 | 24.5 |  | 15999975.50000 | 0 |  | 26666666.6666667 | 0.5 | 1
G#0/Ab0 | 25.96 |  | 15999974.04000 | 0 |  | 40000000 | 0 | 0 |  | Interrupt generator |  |  |  | 40000000 | 0 | 0
A0 | 27.5 |  | 15999972.50000 | 0 |  | 80000000 | -0.5 | -1
A#0/Bb0 | 29.14 |  | 15999970.86000 | 0 |  |  |  |  |  | Reference Clock (CPU / 2)
B0 | 30.87 |  | 15999969.13000 | 0 |  |  |  |  |  | 20000000
C1 | 32.7 |  | 15999967.30000 | 0 |  |  |  |  |  | \/\/\/
C#1/Db1 | 34.65 |  | 15999965.35000 | 0
D1 | 36.71 |  | 15999963.29000 | 0
D#1/Eb1 | 38.89 |  | 15999961.11000 | 0 | <--- | Reference Clock |  |  |  | 1000 | 19999 | 15
E1 | 41.2 |  | 15999958.80000 | 0 |  | 16000000
F1 | 43.65 |  | 15999956.35000 | 0
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
F8 | 5587.65 |  | 15994412.35000 | 0
F#8/Gb8 | 5919.91 |  | 15994080.09000 | 0
G8 | 6271.93 |  | 15993728.07000 | 0
G#8/Ab8 | 6644.88 |  | 15993355.12000 | 0
A8 | 7040 |  | 15992960.00000 | 0
A#8/Bb8 | 7458.62 |  | 15992541.38000 | 0
B8 | 7902.13 |  | 15992097.87000 | 0
