cjgriscom/EEGR4253/Assembly.JPG

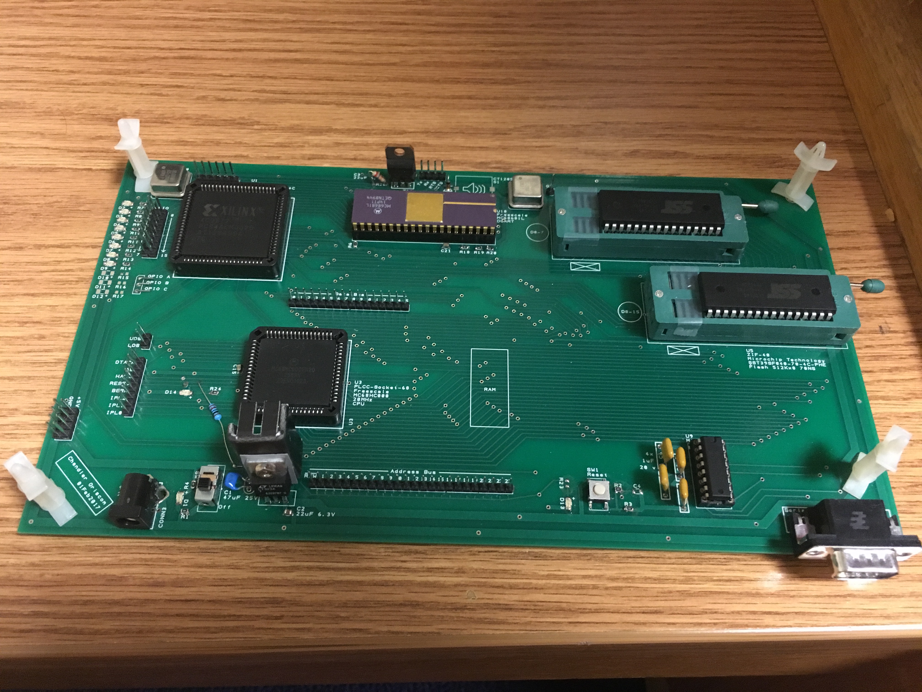
Assembly.JPG
