cjgriscom/EEGR4253/PCB v2/Computer_v2 (PCB - Forward Design Changes Report).txt

Forward Design Changes Report
-----------------------------

Report File:        Y:\Homeschool\Semester6\Microcomputer\PCB v2\Computer_v2 (PCB - Forward Design Changes Report).txt
Report Written:     Tuesday, May 16, 2017
Project Path:       Y:\Homeschool\Semester6\Microcomputer\PCB v2\Computer.prj
Design Path:        Y:\Homeschool\Semester6\Microcomputer\PCB v2\Computer_v2.pcb
Design Title:       
Created:            5/7/2017 6:59:04 PM
Last Saved:         5/16/2017 4:51:31 PM
Editing Time:       10499 min
Units:              inches (precision 3)

The designs are the same, so no design changes to forward.

End Of Report.
