cjgriscom/EEGR4253/Netlist.pdf

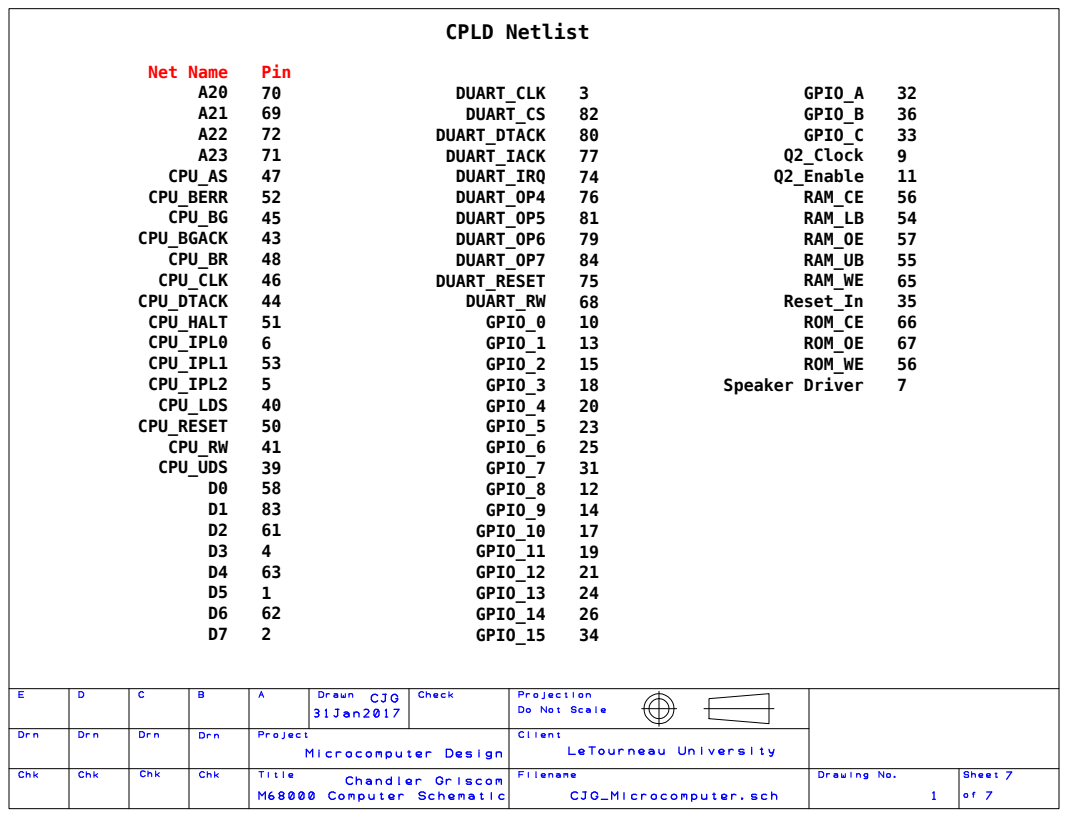
[picture p25: page 1]
