cjgriscom/EEGR4253/Export/SCHEM_EXPORT_11x17.pdf

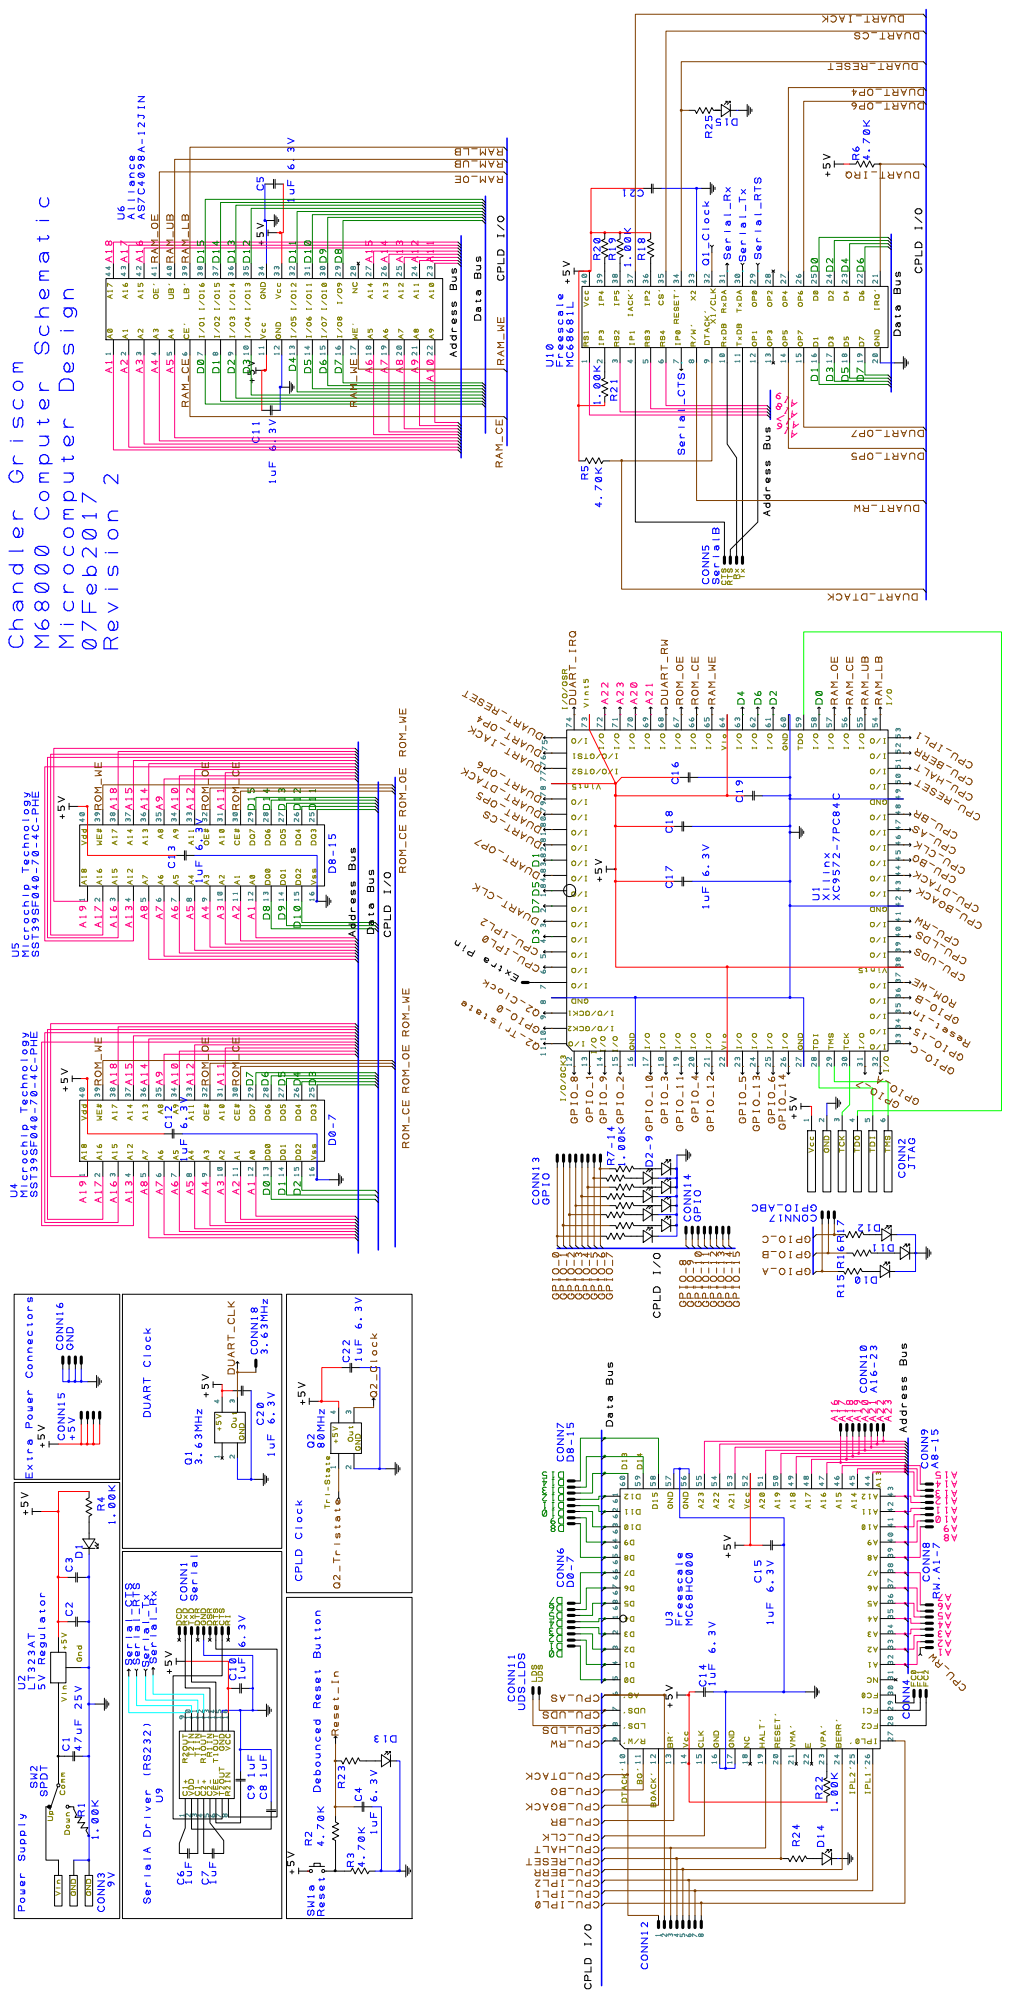
[picture p26: page 1]
