cjgriscom/EEGR4253/Export/PCB_EXPORT.pdf

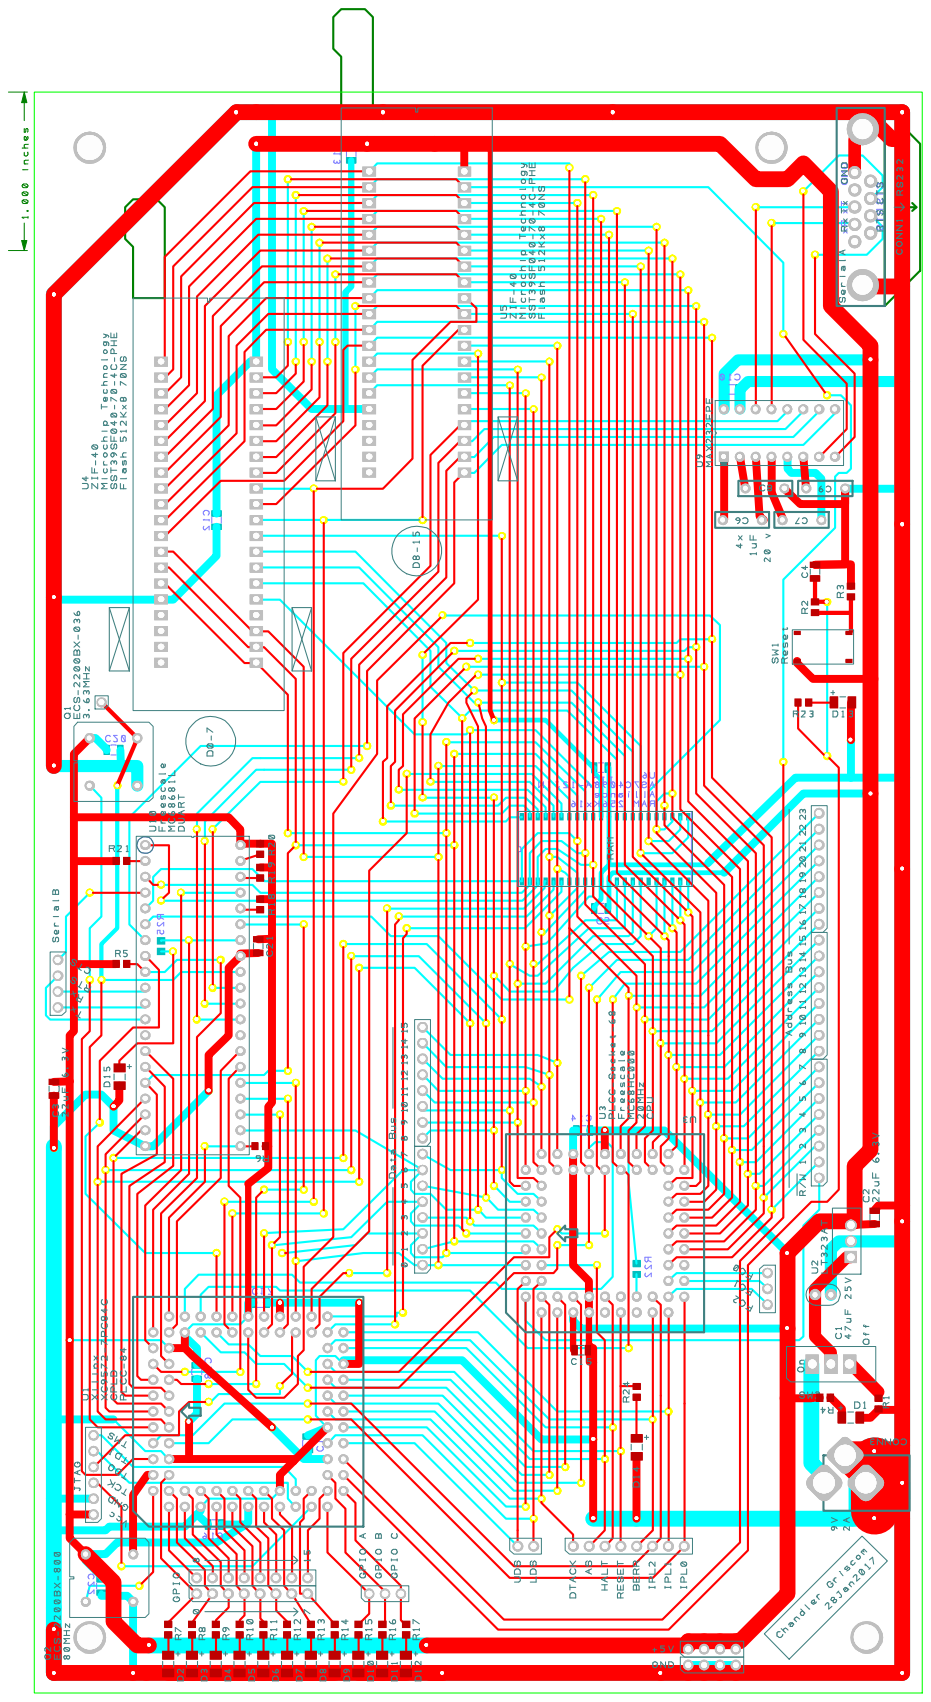
[picture p27: page 1]
