cjgriscom/EEGR4253/Export/PCB_EXPORT_Bottom.pdf

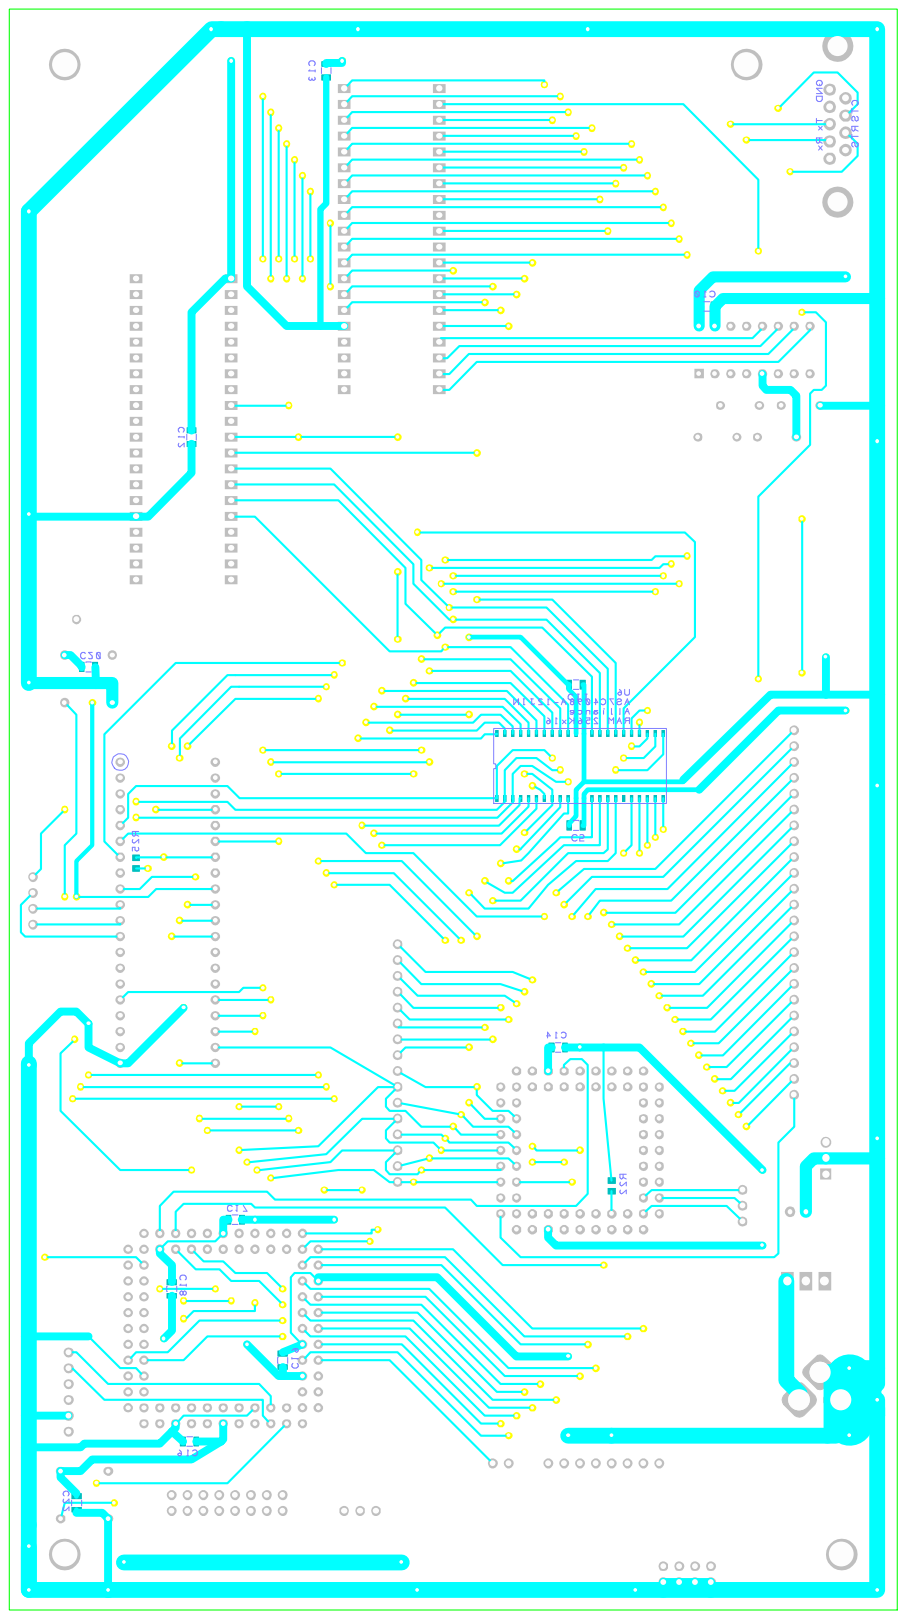
[picture p28: page 1]
