cjgriscom/EEGR4253/Export/PCB_EXPORT_Copper.pdf

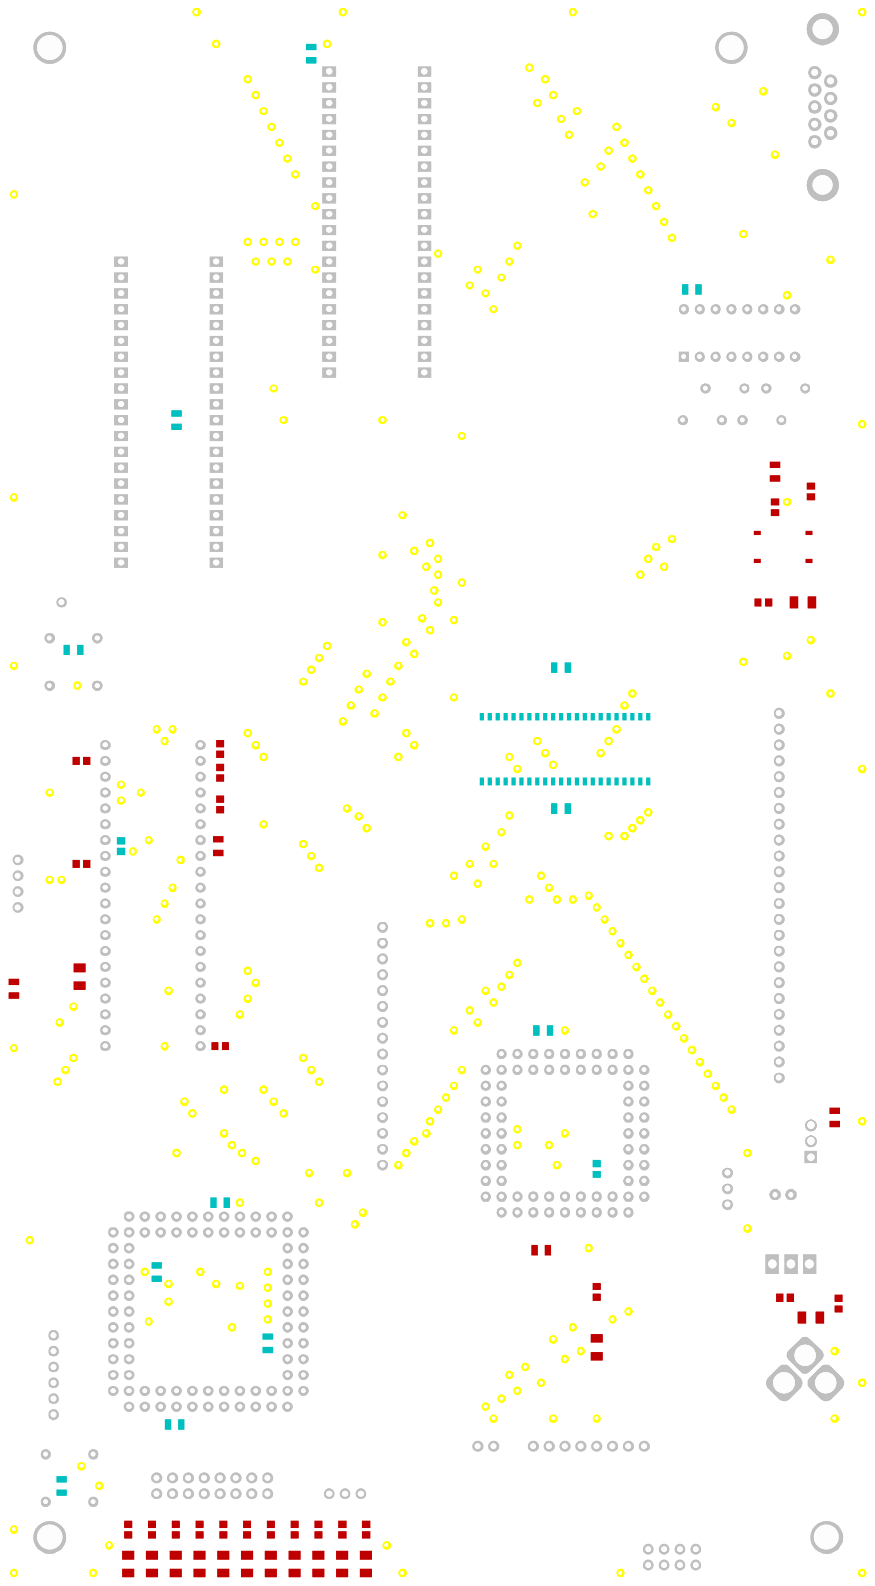
[picture p29: page 1]
