cjgriscom/EEGR4253/Export/PCB_EXPORT_Top.pdf

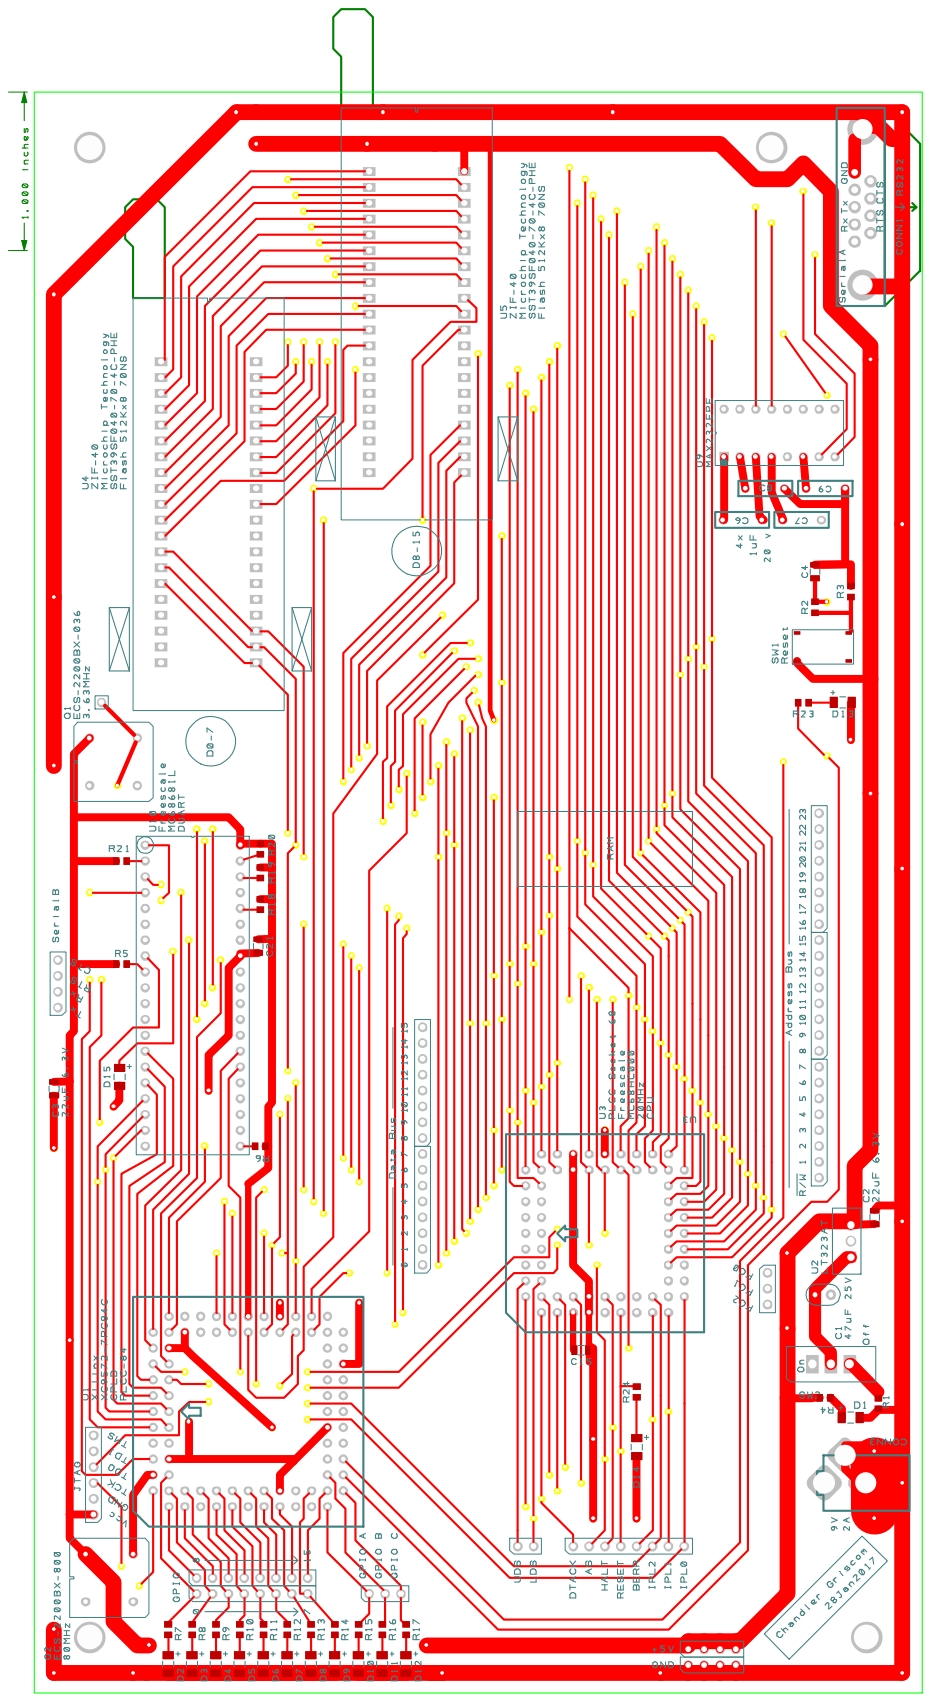
[picture p30: page 1]
