cjgriscom/EEGR4253/(list of files, drawings)

Other design files:
MicroprocLibs/Verification.pcb
PCB v2/Computer.pcb
PCB v2/Computer_v2.pcb
PCB v2/Computer_v2_botched.pcb
