cjgriscom/EEGR4253/PCB v2/Computer (PCB - PCB Configuration Report).txt

PCB Configuration Report
------------------------

Report File:        Y:\Homeschool\Semester6\Microcomputer\Computer (PCB - PCB Configuration Report).txt
Report Written:     Wednesday, February 01, 2017
Project Path:       Y:\Homeschool\Semester6\Microcomputer\Computer.prj
Design Path:        Y:\Homeschool\Semester6\Microcomputer\Computer.pcb
Design Title:       
Created:            1/26/2017 12:31:38 AM
Last Saved:         2/1/2017 1:40:07 AM
Editing Time:       6227 min
Units:              inches (precision 3)

PCB Artist version:       3.2.1


Design Requirement
------------------
Design Requirement Name:  2 Layer Standard


Board
-----
Board Size:               10.100 X 5.600
CNC Route Points:         4


Layers
------
Number of Layers:         2
Powerplanes:              No
Solder Mask:              Yes
    Top Side:             Yes
    Bottom Side:          Yes
    Type:                 LPI
    Color:                Green
Silkscreen:               Yes
    Top Side:             Yes
    Bottom Side:          Yes
    Color:                White


Board Parameters
----------------
Material:                 FR4
Material Thickness:       0.062 inches
Finish Plating:           Lead Free Solder
Copper Weight:            1 oz

Tab Routes:               No
V-Scoring:                No
Plated Slots:             No
Plated Edges:             No
Dielectric:               No
Impedance:                No
Counter Sinks:            No
Counter Bores:            No

Min Track Width (Outer):  0.010 inches
Min Track Width (Inner):  0.010 inches
Min Spacing (Outer):      0.010 inches
Min Spacing (Inner):      0.010 inches
Minimum Hole Size:        0.015 inches
Beveled Gold Fingers:     None


Additional Requirements
-----------------------
Electrical Test:          No
Component Assembly:       No
        Unique Component Parts: 28
        Through Hole:     33
        Fine Pitch:       0
        BGA/Leadless:     0
        Other SMT:        59

Special Requirements: 

                          Student



Production
----------
Board Part Number:        MCU_CJG
Revision Number:          01
Production:               Prototype
Turnaround Time:          1 Week
Quantity:                 1
Array:                    No

Board Unit Price:         $335.44
Board Subtotal Price:     $335.44
Test Price:               $0.00

Total Price:              $335.44


Design Data
-----------
Number of Tracks:         802
Minimum Outer Track Width Used:0.015 inches
Maximum Outer Track Width Used: 0.300 inches

Number of Holes:          712
Number of Hole Sizes:     12
Minimum Hole Size Used:   0.024 inches
Maximum Hole Size Used:   0.157 inches

Number of Top SMT Pads:   90
Number of Bottom SMT Pads: 74
Minimum SMT Pad Pitch:    0.050 inches

Minimum Track (Outer):    0.010 inches

Fiducials:                No

Number of Design Errors:  0

End Of Report.
