cjgriscom/EEGR4253/(commit log)

2017-02-05 Reorganized, finished most VHDL
    [AddressArrangement.ods, MCE_CJG_pad.csv, Project Organizer.ods, noteConvs.csv, noteConvs.ods, noteConvs.odt.csv]
2017-02-05 Add hours, add GPO0 clock, change to 10Mhz
    [MCE_CJG_pad.csv, Project Organizer.ods]
2017-02-06 Update organizer, netlist.
    [Project Organizer.ods]
2017-02-08 Modified schematic (add net labels, 1 page). Report #4
    [Computer.sch, Project Organizer.ods]
2017-02-08 Configure ISE, add more notes to organizer
    [MCE_CJG_pad.csv, Project Organizer.ods]
2017-02-08 Add symmetry-based 16MHz clock
    [MCE_CJG_pad.csv, Project Organizer.ods, noteConvs.ods]
2017-02-08 DTACK can be done without processes
    [MCE_CJG_pad.csv]
2017-02-08 Remove VHDL build artifacts
    [MCE_CJG_pad.csv]
2017-02-10 Reorganize, add board pics, add solder list to organizer
    [Project Organizer.ods, noteConvs.ods]
2017-02-10 Add project file
    [Project Organizer.ods]
2017-02-14 Update organizer, add assembly
    [Project Organizer.ods]
2017-02-14 Update VHDL to current state of testing
2017-02-14 Improve reset logic, blank out interrupts
    [MCE_CJG.vhd]
2017-02-15 Add poweron constraints
2017-02-15 Interrupts are working!
2017-02-15 Timer code
2017-02-15 Update organizer
    [Project Organizer.ods]
2017-02-15 Duart interrupts enabled!
2017-02-15 Fifth weekly report
    [Project Organizer.ods]
2017-02-16 Upload Hello world in boot record, cross fingers
2017-02-17 Update project organizer
    [Project Organizer.ods]
2017-02-17 Fix data bus collisions during DUART interrupts
    [MCE_CJG.vhd]
2017-02-18 Progress on monitor program, ROM hotswapping
    [Project Organizer.ods]
2017-02-20 Fix hotswap bug, change interrupt levels
    [MCE_CJG.vhd]
2017-02-20 Fix another hotswap CPLD bug
    [MCE_CJG.vhd]
2017-02-21 Improve hotswapping and reset button logic
2017-02-22 Progress report 6, ROMBurner modifications, serial B communication
    [Project Organizer.ods]
2017-03-04 ROM-writing functionality in Monitor program
    [Monitor Design.ods, Project Organizer.ods]
2017-03-05 Completed monitor program and h-bridge controller test record
    [Project Organizer.ods]
2017-03-19 Switch baud to 19200
2017-04-24 Add pictures, final report
    [Project Organizer.ods]
2017-05-12 New PCB design
    [Computer (PCB - PCB Configuration Report).txt, Computer.pcb, Computer.sch, Computer_v2.pcb]
2017-05-12 Modified new PCB
    [Computer.sch, Computer_v2.pcb]
2017-05-12 More PCB changes
    [Computer.sch, Computer_v2.pcb]
2017-05-13 Unroute CPLD
    [Computer.sch, Computer_v2.pcb, Computer_v2_botched.pcb]
2017-05-13 Clean up nets
    [Computer_v2.pcb]
2017-05-13 More CPLD cleanup
    [Computer_v2.pcb]
2017-05-13 Begin new CPLD layout
    [Computer_v2.pcb]
2017-05-13 Prepare for moving ROM inputs
    [Computer.sch, Computer_v2.pcb]
2017-05-14 Add most of CPLD routing
    [Computer.sch, Computer_v2.pcb]
2017-05-14 Prepare to rip out CPLD again
    [Computer_v2.pcb]
2017-05-15 Nearly done routing CPLD
    [Computer_v2.pcb]
2017-05-15 Finished routing CPLD
    [Computer_v2.pcb]
2017-05-16 Prepare for net matching
    [Computer_v2.pcb]
2017-05-16 Completed first attempt at renames
    [Computer.sch, Computer_v2.pcb]
2017-05-16 Pass consistancy check
    [Computer.sch]
2017-05-16 Rule check passes
    [Computer_v2.pcb]
